JoaoWMHentz/Kinematech_Torq/Torq150A/Torq150A.step

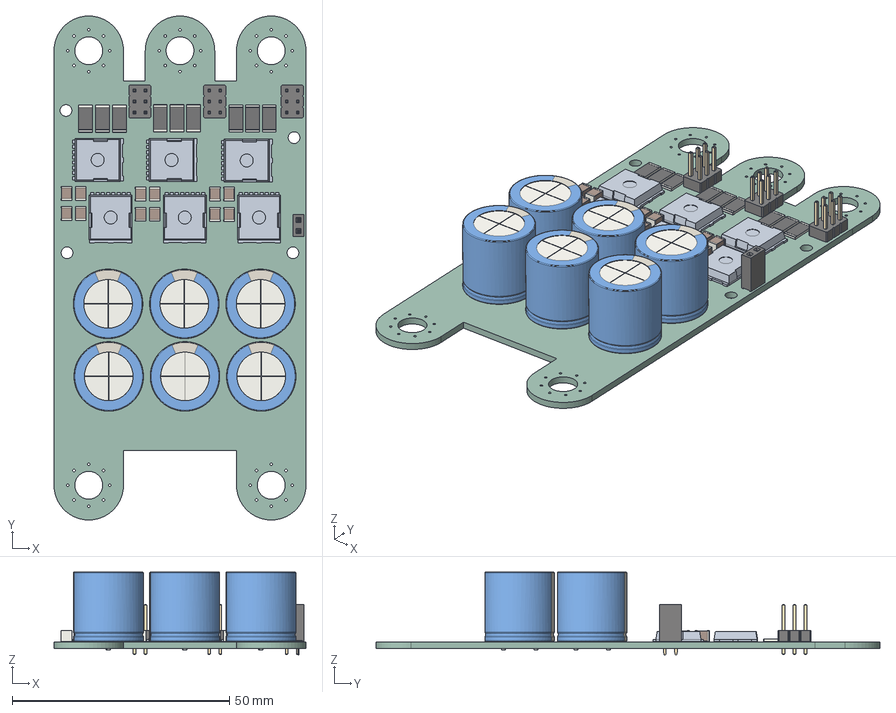
[picture p1: CAD file, 2025-09-10]
Torq150A/Torq150A.step
58.0 x 116.0 x 19.1 mm
C_1210_3225Metric x 12
PinSocket_1x02_P2.54mm_Vertical
PinHeader_2x03_P2.54mm_Vertical x 3
R_2512_6332Metric x 9
CP_Radial_D16.0mm_P7.50mm x 6
Torq150A 1.11.1 x 6
Torq150A_PCB
