JoaoWMHentz/Kinematech_Torq/TorqController/TorqController/Torq150.FCStd

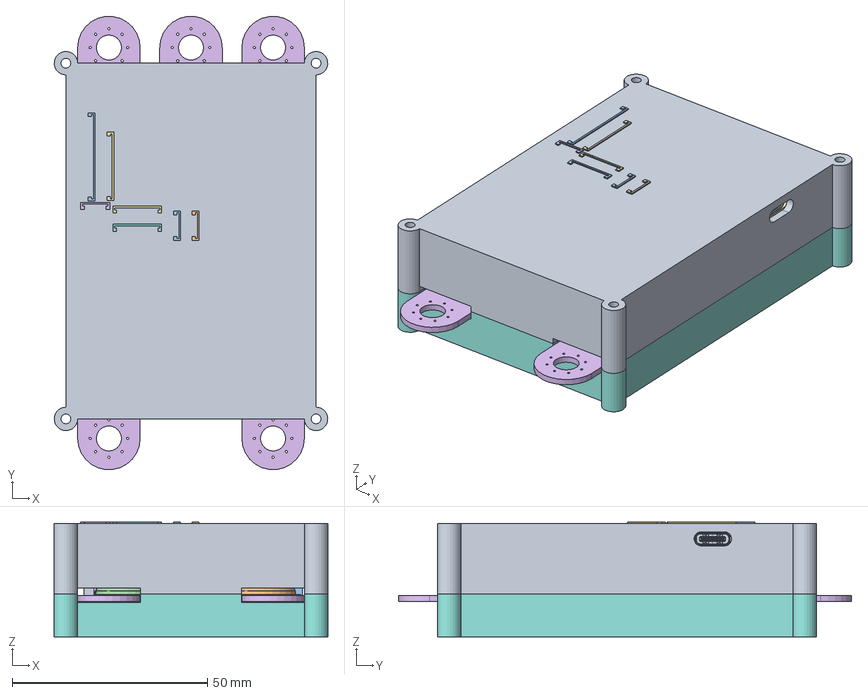
[picture p2: CAD file, 2025-09-10]
TorqController/TorqController/Torq150.FCStd
70.0 x 115.9 x 29.3 mm
C_1210_3225Metric
C_1210_3225Metric001
PinSocket_1x02_P2.54mm_Vertical
PinHeader_2x03_P2.54mm_Vertical
R_2512_6332Metric
C_1210_3225Metric002
CP_Radial_D16.0mm_P7.50mm
CP_Radial_D16.0mm_P7.50mm001
C_1210_3225Metric003
CP_Radial_D16.0mm_P7.50mm002
Torq150A 1.11.1
R_2512_6332Metric001
C_1210_3225Metric004
R_2512_6332Metric002
PinHeader_2x03_P2.54mm_Vertical001
R_2512_6332Metric003
Torq150A 1.11.002
R_2512_6332Metric004
R_2512_6332Metric005
Torq150A 1.11.003
CP_Radial_D16.0mm_P7.50mm003
R_2512_6332Metric006
C_1210_3225Metric005
R_2512_6332Metric007
Torq150A 1.11.004
C_1210_3225Metric006
CP_Radial_D16.0mm_P7.50mm004
CP_Radial_D16.0mm_P7.50mm005
C_1210_3225Metric007
C_1210_3225Metric008
C_1210_3225Metric009
C_1210_3225Metric010
Torq150A 1.11.005
Torq150A 1.11.006
C_1210_3225Metric011
PinHeader_2x03_P2.54mm_Vertical002
R_2512_6332Metric008
Torq150A_PCB
R_0402_1005Metric
C_0402_1005Metric
CP_Elec_3x5.4
R_0402_1005Metric001
R_0402_1005Metric002
WSON-8-1EP_3x3mm_P0.5mm_EP1.6x2.0mm
R_0402_1005Metric003
TSSOP-8_4.4x3mm_P0.65mm
R_0402_1005Metric004
CP_EIA-3216-10_Kemet-I
R_0402_1005Metric005
Texas_HTSSOP-14-1EP_4.4x5mm_P0.65mm_EP3.4x5mm_Mask3.155x3.255mm
R_0402_1005Metric006
C_0402_1005Metric001
C_0402_1005Metric002
CP_EIA-3216-10_Kemet-I001
C_0402_1005Metric003
R_0402_1005Metric007
R_0402_1005Metric008
R_0402_1005Metric009
R_0402_1005Metric010
R_0402_1005Metric011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
