JoaoWMHentz/Kinematech_Torq/Torq150A/Torq150A.kicad_pcb

## KiCad design Torq150A/Torq150A.kicad_pcb (2025-09-10)

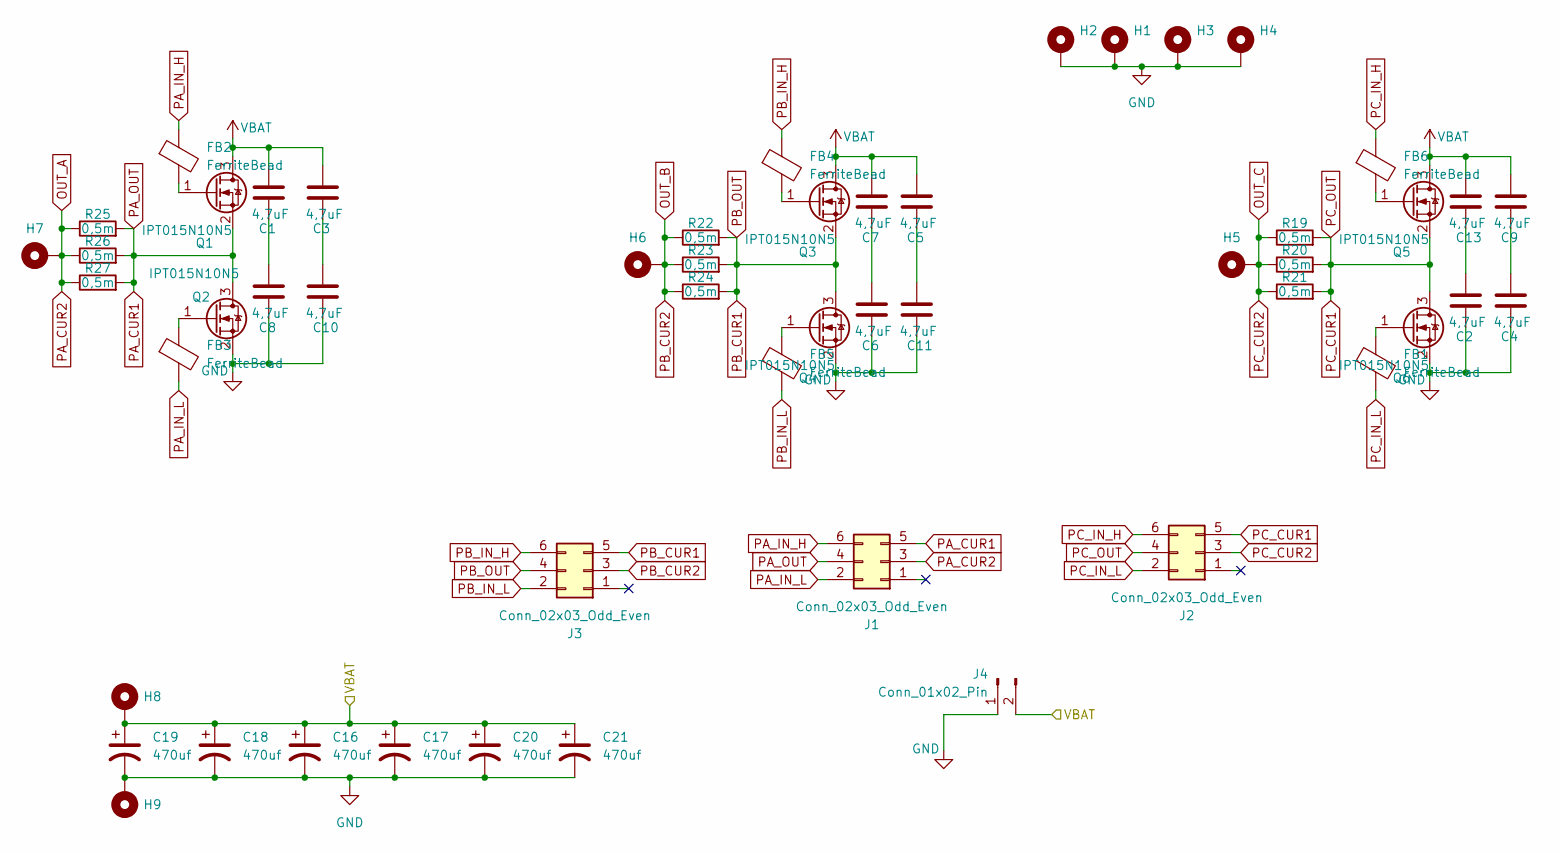
[picture p3: schematic Torq150A.kicad_sch]

Parts:
C1, C2, C3, C4, C5, C6, C7, C8, C9, C10, C11, C13: 4,7uF; C_1210_3225Metric
C16, C17, C18, C19, C20, C21: 470uf; CP_Radial_D16.0mm_P7.50mm
FB1, FB2, FB3, FB4, FB5, FB6: FerriteBead; L_Coilcraft_0805HQ_2012Metric
H1, H2, H3, H4: MountingHole_Pad; MountingHole_2.7mm_M2.5_ISO7380_Pad
H5, H6, H7, H8, H9: MountingHole_Pad; MountingHole_6.4mm_M6_Pad_Via
J1, J2, J3: Conn_02x03_Odd_Even; PinHeader_2x03_P2.54mm_Vertical
J4: Conn_01x02_Pin; PinSocket_1x02_P2.54mm_Vertical
Q1, Q2, Q3, Q4, Q5, Q6: IPT015N10N5; Infineon_PG-HSOF-8-1
R19, R20, R21, R22, R23, R24, R25, R26, R27: 0,5m; R_2512_6332Metric

Connections:
GND: C2.2, C4.2, C6.2, C8.2, C10.2, C11.2, C16.2, C17.2, C18.2, C19.2, C20.2, C21.2, H1.1, H2.1, H3.1, H4.1, H9.1, J4.1, Q2.2 (S), Q4.2 (S), Q6.2 (S)
unnamed: C1.2, C8.1
unnamed: C4.1, C9.2
unnamed: C6.1, C7.2
unnamed: C3.2, C10.1
unnamed: C5.2, C11.1
unnamed: C2.1, C13.2
unnamed: FB2.2, Q1.1 (G)
unnamed: FB3.1, Q2.1 (G)
unnamed: FB4.2, Q3.1 (G)
unnamed: FB5.1, Q4.1 (G)
unnamed: FB6.2, Q5.1 (G)
unnamed: FB1.1, Q6.1 (G)
OUT_A: H7.1, J1.3, R25.1, R26.1, R27.1
OUT_B: H6.1, J3.3, R22.1, R23.1, R24.1
OUT_C: H5.1, J2.3, R19.1, R20.1, R21.1
PA_CUR1: J1.4, J1.5, Q1.2 (S), Q2.3 (D), R25.2, R26.2, R27.2
PA_IN_H: FB2.1, J1.6
PA_IN_L: FB3.2, J1.2
PB_CUR1: J3.4, J3.5, Q3.2 (S), Q4.3 (D), R22.2, R23.2, R24.2
PB_IN_H: FB4.1, J3.6
PB_IN_L: FB5.2, J3.2
PC_CUR1: J2.4, J2.5, Q5.2 (S), Q6.3 (D), R19.2, R20.2, R21.2
PC_IN_H: FB6.1, J2.6
PC_IN_L: FB1.2, J2.2
VBAT: C1.1, C3.1, C5.1, C7.1, C9.1, C13.1, C16.1, C17.1, C18.1, C19.1, C20.1, C21.1, H8.1, J4.2, Q1.3 (D), Q3.3 (D), Q5.3 (D)

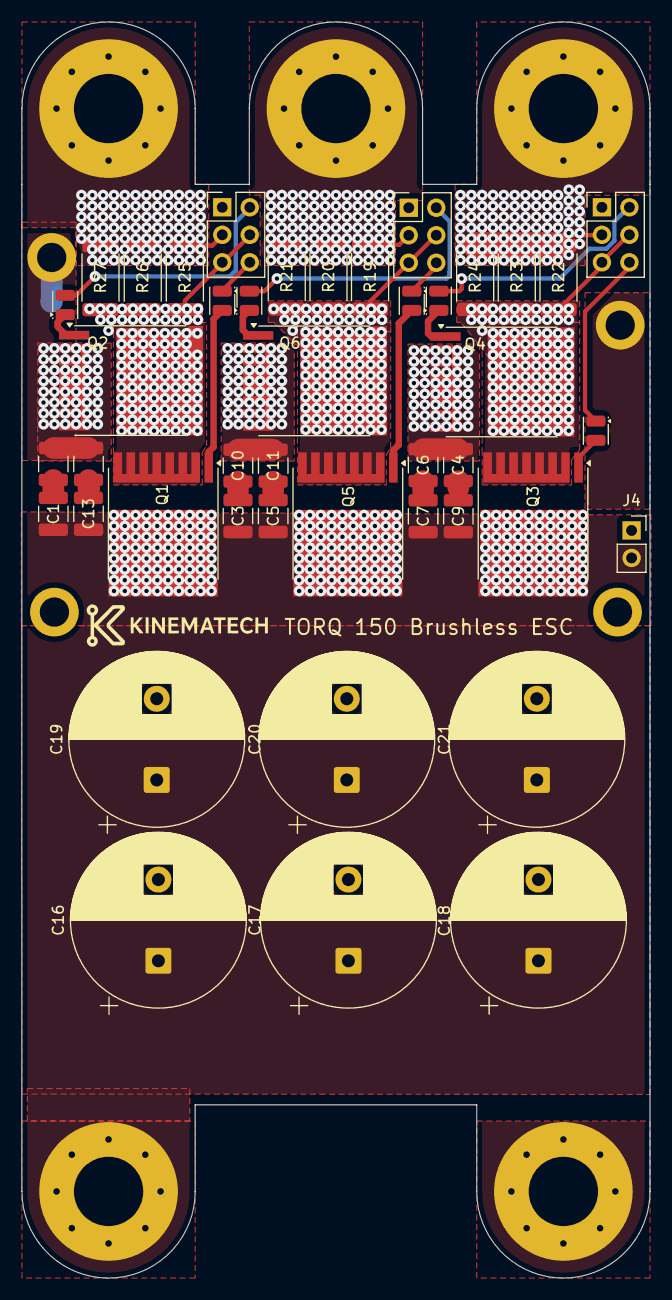
[picture p4: board Torq150A.kicad_pcb from above]

Board: 2 copper layers, 58.0 x 116.0 mm, 52 parts (0 on the bottom side), 26 nets.
