JoaoWMHentz/Kinematech_Torq/TorqController/TorqController/TorqController.kicad_pcb

## KiCad design TorqController/TorqController/TorqController.kicad_pcb (2025-09-10)

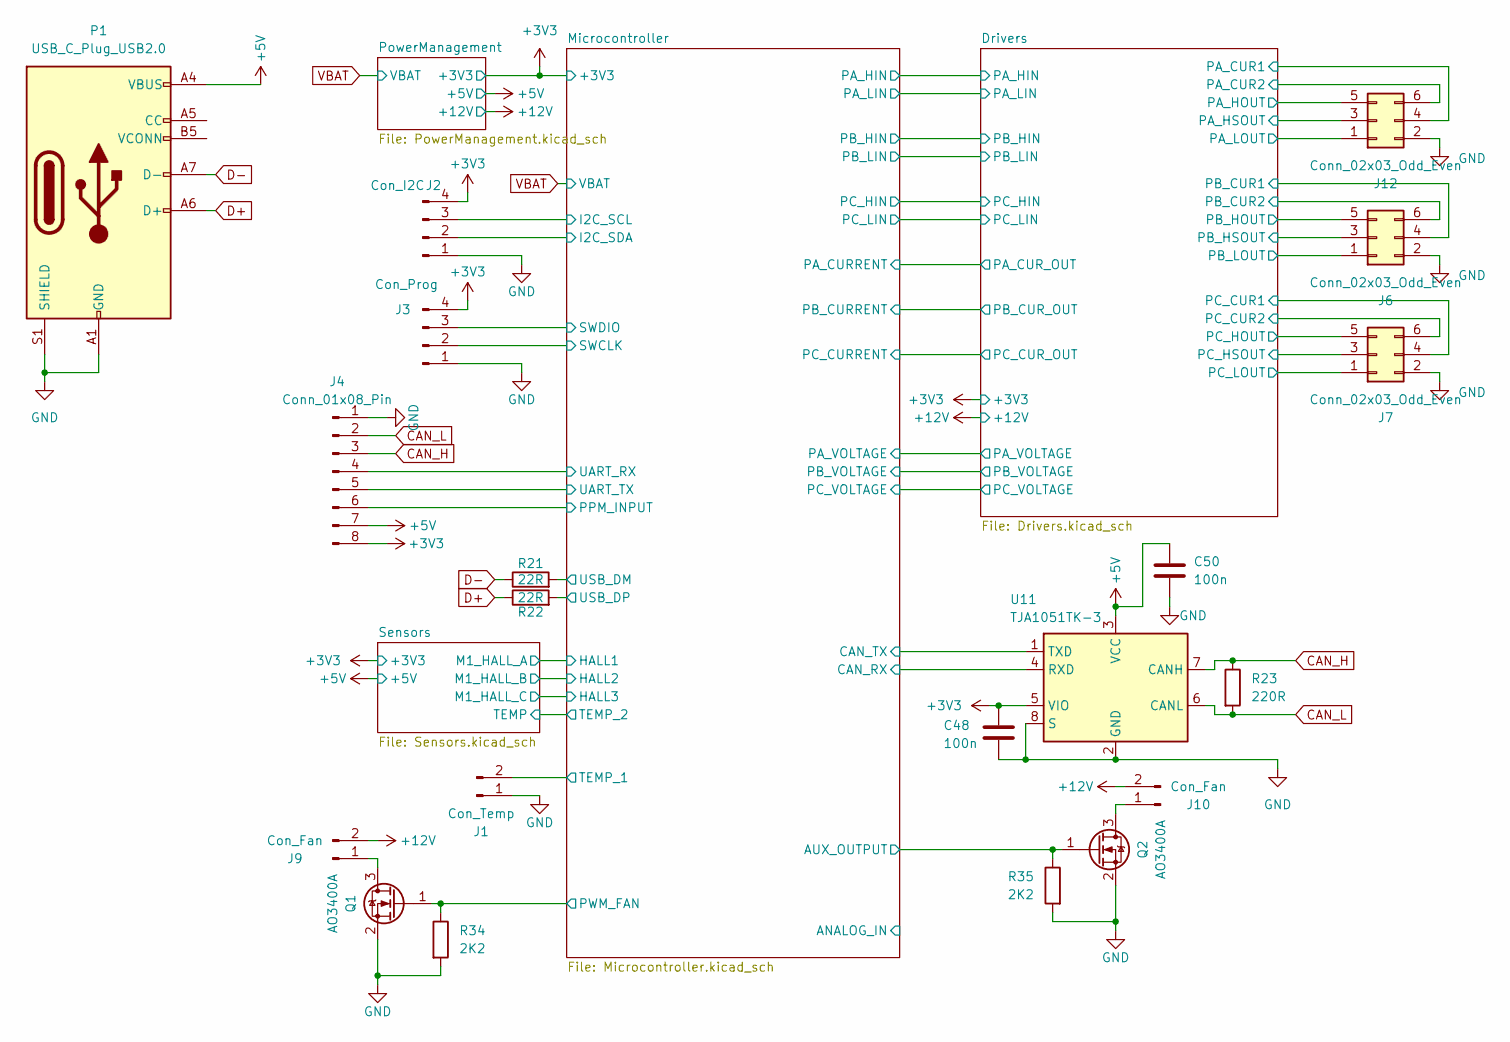
[picture p5: schematic TorqController.kicad_sch]

Parts:
C48, C50: 100n; C_0402_1005Metric
J1: Con_Temp; JST_EH_B2B-EH-A_1x02_P2.50mm_Vertical
J2: Con_I2C; JST_EH_B4B-EH-A_1x04_P2.50mm_Vertical
J3: Con_Prog; JST_EH_B4B-EH-A_1x04_P2.50mm_Vertical
J4: Conn_01x08_Pin; JST_EH_B8B-EH-A_1x08_P2.50mm_Vertical
J6, J7, J12: Conn_02x03_Odd_Even; PinHeader_2x03_P2.54mm_Vertical
J9, J10: Con_Fan; JST_EH_B2B-EH-A_1x02_P2.50mm_Vertical
P1: USB_C_Plug_USB2.0; USB_C_Receptacle_G-Switch_GT-USB-7010ASV
Q1, Q2: AO3400A; SOT-23
R21, R22: 22R; R_0402_1005Metric
R23: 220R; R_0402_1005Metric
R34, R35: 2K2; R_0402_1005Metric
U11: TJA1051TK-3; HVSON-8-1EP_3x3mm_P0.65mm_EP1.6x2.4mm

Connections:
+3V3: C48.1, J2.4, J3.4, J4.8, U11.5 (VIO); also elsewhere on the board
+5V: C50.1, J4.7, P1.A4 (VBUS), P1.A9 (VBUS), P1.B4 (VBUS), P1.B9 (VBUS), U11.3 (VCC); also elsewhere on the board
+12V: J9.2, J10.2; also elsewhere on the board
/Drivers/PA_CUR1: J12.4; also elsewhere on the board
/Drivers/PA_CUR2: J12.6; also elsewhere on the board
/Drivers/PA_HOUT: J12.5; also elsewhere on the board
/Drivers/PA_HSOUT: J12.3; also elsewhere on the board
/Drivers/PA_LOUT: J12.1; also elsewhere on the board
/Drivers/PB_CUR1: J6.4; also elsewhere on the board
/Drivers/PB_CUR2: J6.6; also elsewhere on the board
/Drivers/PB_HOUT: J6.5; also elsewhere on the board
/Drivers/PB_HSOUT: J6.3; also elsewhere on the board
/Drivers/PB_LOUT: J6.1; also elsewhere on the board
/Drivers/PC_CUR1: J7.4; also elsewhere on the board
/Drivers/PC_CUR2: J7.6; also elsewhere on the board
/Drivers/PC_HOUT: J7.5; also elsewhere on the board
/Drivers/PC_HSOUT: J7.3; also elsewhere on the board
/Drivers/PC_LOUT: J7.1; also elsewhere on the board
/Microcontroller/AUX_OUTPUT: Q2.1 (G), R35.1; also elsewhere on the board
/Microcontroller/CAN_RX: U11.4 (RXD); also elsewhere on the board
/Microcontroller/CAN_TX: U11.1 (TXD); also elsewhere on the board
/Microcontroller/I2C_SCL: J2.3; also elsewhere on the board
/Microcontroller/I2C_SDA: J2.2; also elsewhere on the board
/Microcontroller/PPM_INPUT: J4.6; also elsewhere on the board
/Microcontroller/PWM_FAN: Q1.1 (G), R34.1; also elsewhere on the board
/Microcontroller/SWCLK: J3.2; also elsewhere on the board
/Microcontroller/SWDIO: J3.3; also elsewhere on the board
/Microcontroller/UART_RX: J4.4; also elsewhere on the board
/Microcontroller/UART_TX: J4.5; also elsewhere on the board
/Microcontroller/USB_DM: R21.2; also elsewhere on the board
/Microcontroller/USB_DP: R22.2; also elsewhere on the board
CAN_H: J4.3, R23.1, U11.7 (CANH)
CAN_L: J4.2, R23.2, U11.6 (CANL)
D+: P1.A6 (D+), R22.1
D-: P1.A7 (D-), R21.1
GND: C48.2, C50.2, J1.1, J2.1, J3.1, J4.1, J6.2, J7.2, J12.2, P1.A1 (GND), P1.A12 (GND), P1.B1 (GND), P1.B12 (GND), P1.S1 (SHIELD), Q1.2 (S), Q2.2 (S), R34.2, R35.2, U11.2 (GND), U11.8 (S), U11.9 (GND); also elsewhere on the board
unnamed: J9.1, Q1.3 (D)
unnamed: J10.1, Q2.3 (D)
Temp_1: J1.2; also elsewhere on the board

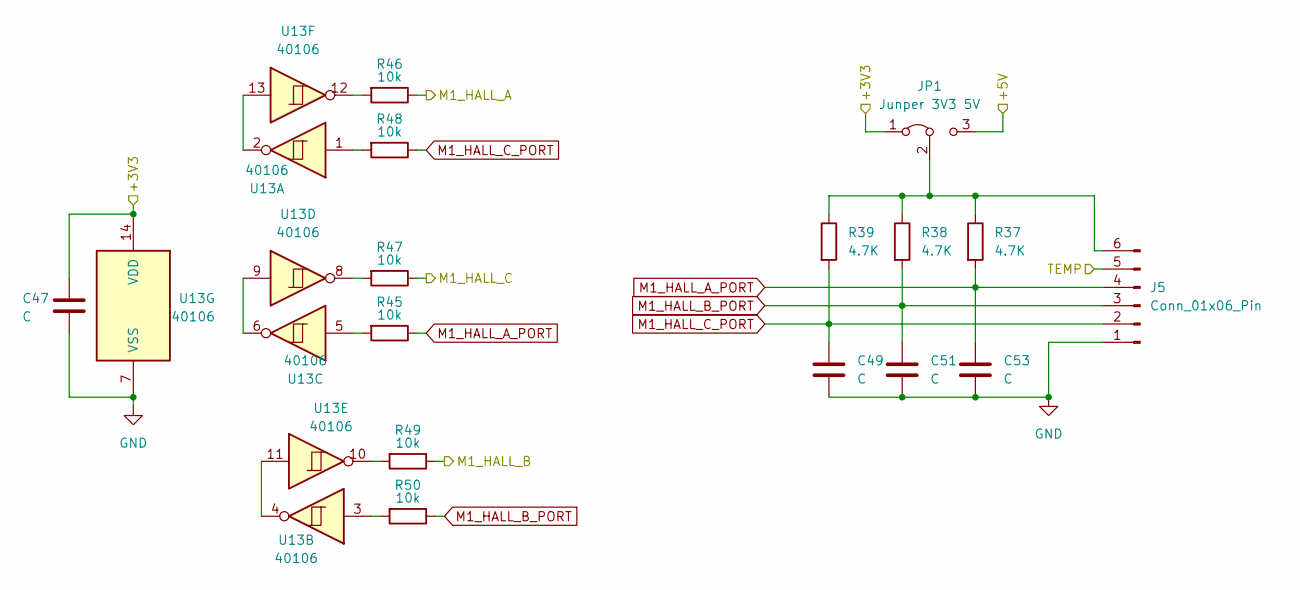
[picture p6: schematic Sensors.kicad_sch]

Parts:
C47, C49, C51, C53: C; C_0402_1005Metric
J5: Conn_01x06_Pin; JST_EH_B6B-EH-A_1x06_P2.50mm_Vertical
JP1: Junper 3V3 5V; SolderJumper-3_P1.3mm_Open_RoundedPad1.0x1.5mm_NumberLabels
R37, R38, R39: 4.7K; R_0402_1005Metric
R45, R46, R47, R48, R49, R50: 10k; R_0402_1005Metric
U13: 40106; DIP-14_W7.62mm_SMDSocket_SmallPads

Connections:
+3V3: C47.1, JP1.1 (A), U13.14 (VDD); also elsewhere on the board
/Microcontroller/HALL1: R46.1; also elsewhere on the board
/Microcontroller/HALL2: R49.1; also elsewhere on the board
/Microcontroller/HALL3: R47.1; also elsewhere on the board
GND: C47.2, C49.2, C51.2, C53.2, J5.1, U13.7 (VSS); also elsewhere on the board
M1_HALL_A_PORT: C53.1, J5.4, R37.2, R45.1
M1_HALL_B_PORT: C51.1, J5.3, R38.2, R50.1
M1_HALL_C_PORT: C49.1, J5.2, R39.2, R48.1
unnamed 60: J5.6, JP1.2 (C), R37.1, R38.1, R39.1; also elsewhere on the board
unnamed: R45.2, U13.5
unnamed: R46.2, U13.12
unnamed: R47.2, U13.8
unnamed: R48.2, U13.1
unnamed: R49.2, U13.10
unnamed: R50.2, U13.3
unnamed: U13.6, U13.9
unnamed: U13.4, U13.11
unnamed: U13.2, U13.13
Temp_2: J5.5; also elsewhere on the board

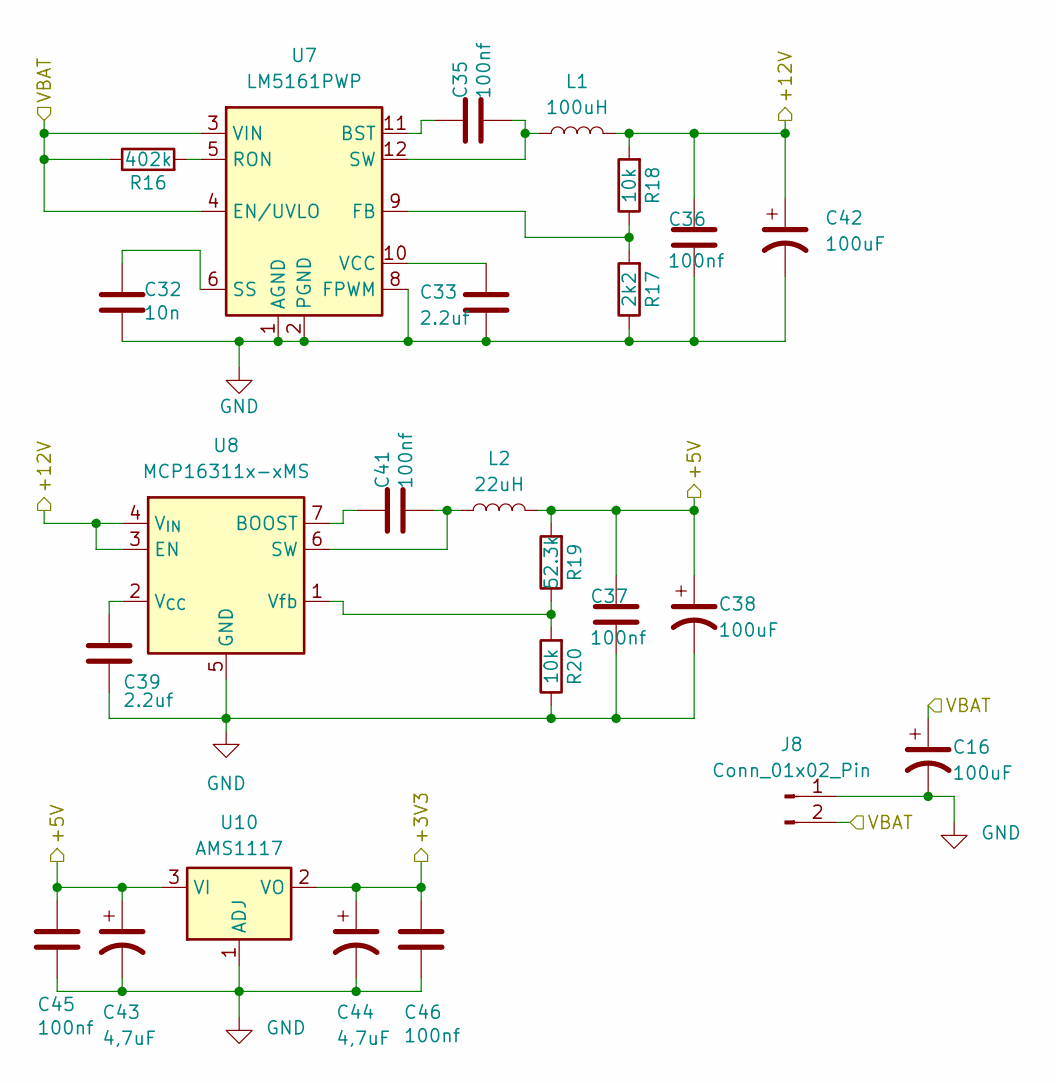
[picture p7: schematic PowerManagement.kicad_sch]

Parts:
C16, C38, C42: 100uF; CP_Elec_3x5.4
C32: 10n; C_0402_1005Metric
C33, C39: 2.2uf; C_0603_1608Metric
C35, C36, C37, C41, C45, C46: 100nf; C_0402_1005Metric
C43, C44: 4,7uF; CP_EIA-3216-10_Kemet-I
J8: Conn_01x02_Pin; PinHeader_1x02_P2.54mm_Vertical
L1: 100uH; L_KOHERelec_MDA5030
L2: 22uH; L_Chilisin_BMRB00050518-B
R16: 402k; R_0402_1005Metric
R17: 2k2; R_0402_1005Metric
R18, R20: 10k; R_0402_1005Metric
R19: 52.3k; R_0402_1005Metric
U7: LM5161PWP; Texas_HTSSOP-14-1EP_4.4x5mm_P0.65mm_EP3.4x5mm_Mask3.155x3.2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
U8: MCP16311x-xMS; MSOP-8_3x3mm_P0.65mm
U10: AMS1117; SOT-223-3_TabPin2

Connections:
+3V3: C44.1, C46.1, U10.2 (VO); also elsewhere on the board
+5V: C37.2, C38.1, C43.1, C45.1, L2.2, R19.2, U10.3 (VI); also elsewhere on the board
+12V: C36.2, C42.1, L1.2, R18.2, U8.3 (EN), U8.4 (V_{IN}); also elsewhere on the board
GND: C16.2, C32.2, C33.2, C36.1, C37.1, C38.2, C39.2, C42.2, C43.2, C44.2, C45.2, C46.2, J8.1, R17.1, R20.1, U7.1 (AGND), U7.2 (PGND), U7.8 (FPWM), U7.15 (AGND), U8.5 (GND), U8.8 (GND), U10.1 (ADJ); also elsewhere on the board
unnamed: C35.2, L1.1, U7.12 (SW), U7.13 (SW)
unnamed: C35.1, U7.11 (BST)
unnamed: R17.2, R18.1, U7.9 (FB)
unnamed: R16.2, U7.5 (RON)
unnamed: C32.1, U7.6 (SS)
unnamed: C33.1, U7.10 (VCC)
unnamed: C41.1, U8.7 (BOOST)
unnamed: C41.2, L2.1, U8.6 (SW)
unnamed: C39.1, U8.2 (V_{CC})
unnamed: R19.1, R20.2, U8.1 (Vfb)
VBAT: C16.1, J8.2, R16.1, U7.3 (VIN), U7.4 (EN/UVLO); also elsewhere on the board

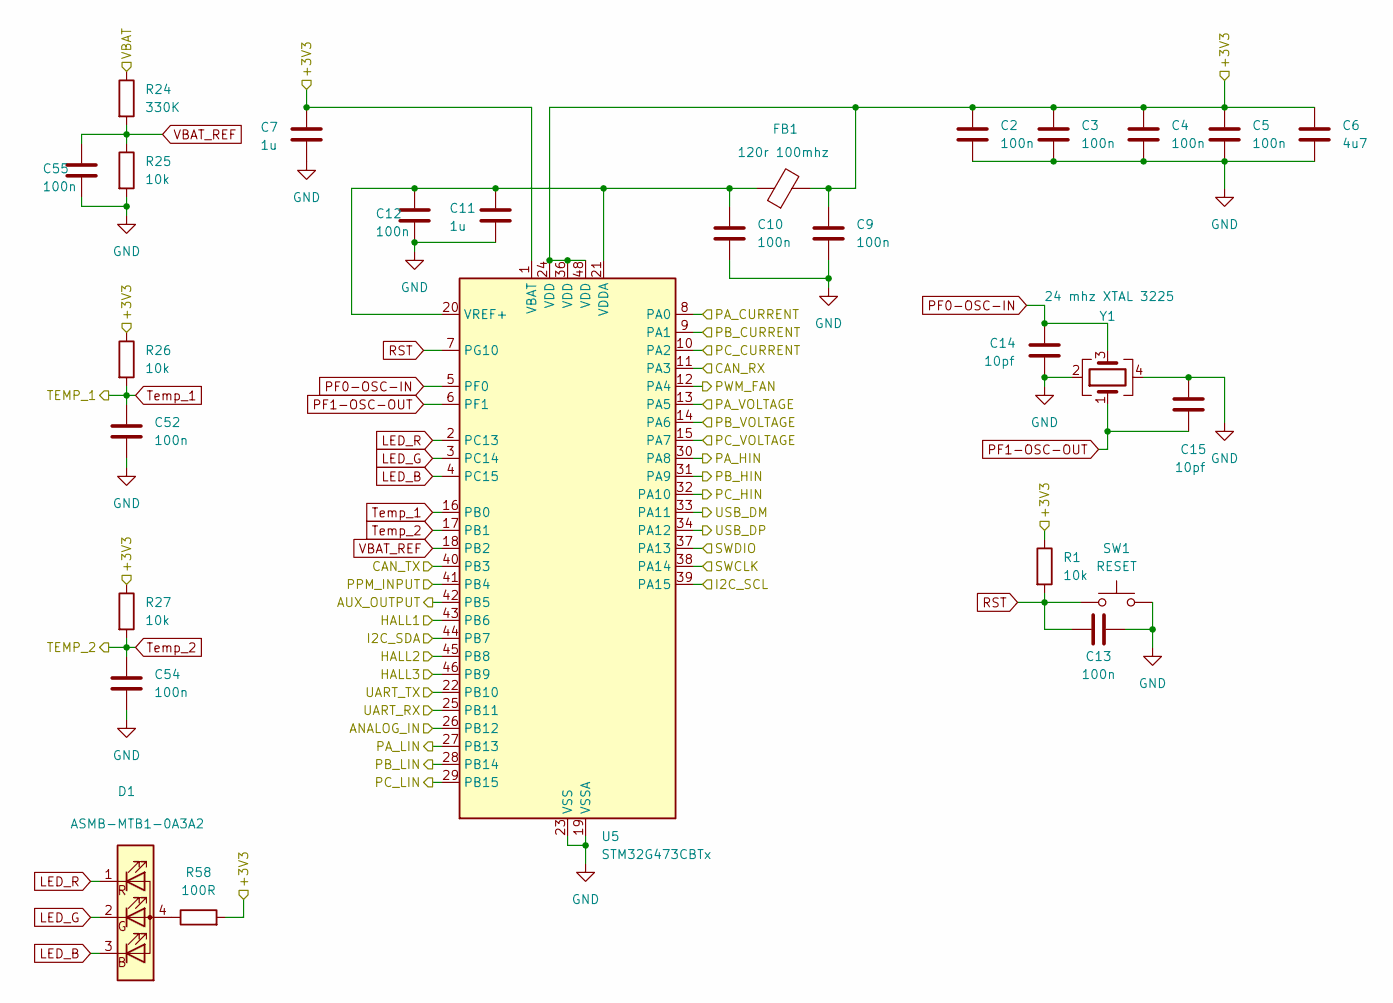
[picture p8: schematic Microcontroller.kicad_sch]

Parts:
C2, C3, C4, C5, C9, C10, C12, C13, C52, C54, C55: 100n; C_0402_1005Metric
C6: 4u7; C_0402_1005Metric
C7, C11: 1u; C_0402_1005Metric
C14, C15: 10pf; C_0402_1005Metric
D1: ASMB-MTB1-0A3A2; LED_Avago_PLCC4_3.2x2.8mm_CW
FB1: 120r 100mhz; L_0402_1005Metric
R1, R25, R26, R27: 10k; R_0402_1005Metric
R24: 330K; R_0402_1005Metric
R58: 100R; R_0603_1608Metric_Pad0.98x0.95mm_HandSolder
SW1: RESET; SW_SPST_B3U-1000P
U5: STM32G473CBTx; LQFP-48_7x7mm_P0.5mm
Y1: 24 mhz XTAL 3225; Crystal_SMD_2016-4Pin_2.0x1.6mm

Connections:
+3V3: C2.1, C3.1, C4.1, C5.1, C6.1, C7.1, C9.1, FB1.2, R1.1, R26.1, R27.1, R58.2, U5.1 (VBAT), U5.24 (VDD), U5.36 (VDD), U5.48 (VDD); also elsewhere on the board
/Drivers/PA_CUR_OUT: U5.8 (PA0); also elsewhere on the board
/Drivers/PA_HIN: U5.30 (PA8); also elsewhere on the board
/Drivers/PA_LIN: U5.27 (PB13); also elsewhere on the board
/Drivers/PA_VOLTAGE: U5.13 (PA5); also elsewhere on the board
/Drivers/PB_CUR_OUT: U5.9 (PA1); also elsewhere on the board
/Drivers/PB_HIN: U5.31 (PA9); also elsewhere on the board
/Drivers/PB_LIN: U5.28 (PB14); also elsewhere on the board
/Drivers/PB_VOLTAGE: U5.14 (PA6); also elsewhere on the board
/Drivers/PC_CUR_OUT: U5.10 (PA2); also elsewhere on the board
/Drivers/PC_HIN: U5.32 (PA10); also elsewhere on the board
/Drivers/PC_LIN: U5.29 (PB15); also elsewhere on the board
/Drivers/PC_VOLTAGE: U5.15 (PA7); also elsewhere on the board
/Microcontroller/ANALOG_IN: U5.26 (PB12)
/Microcontroller/AUX_OUTPUT: U5.42 (PB5); also elsewhere on the board
/Microcontroller/CAN_RX: U5.11 (PA3); also elsewhere on the board
/Microcontroller/CAN_TX: U5.40 (PB3); also elsewhere on the board
/Microcontroller/HALL1: U5.43 (PB6); also elsewhere on the board
/Microcontroller/HALL2: U5.45 (PB8); also elsewhere on the board
/Microcontroller/HALL3: U5.46 (PB9); also elsewhere on the board
/Microcontroller/I2C_SCL: U5.39 (PA15); also elsewhere on the board
/Microcontroller/I2C_SDA: U5.44 (PB7); also elsewhere on the board
/Microcontroller/PPM_INPUT: U5.41 (PB4); also elsewhere on the board
/Microcontroller/PWM_FAN: U5.12 (PA4); also elsewhere on the board
/Microcontroller/SWCLK: U5.38 (PA14); also elsewhere on the board
/Microcontroller/SWDIO: U5.37 (PA13); also elsewhere on the board
/Microcontroller/UART_RX: U5.25 (PB11); also elsewhere on the board
/Microcontroller/UART_TX: U5.22 (PB10); also elsewhere on the board
/Microcontroller/USB_DM: U5.33 (PA11); also elsewhere on the board
/Microcontroller/USB_DP: U5.34 (PA12); also elsewhere on the board
GND: C2.2, C3.2, C4.2, C5.2, C6.2, C7.2, C9.2, C10.2, C11.2, C12.2, C13.2, C14.2, C15.1, C52.2, C54.2, C55.2, R25.2, SW1.2, U5.19 (VSSA), U5.23 (VSS), U5.35 (VSS), U5.47 (VSS), Y1.2, Y1.4; also elsewhere on the board
LED_B: D1.3 (BK), U5.4 (PC15)
LED_G: D1.2 (GK), U5.3 (PC14)
LED_R: D1.1 (RK), U5.2 (PC13)
unnamed: D1.4 (A), R58.1
unnamed: C10.1, C11.1, C12.1, FB1.1, U5.20 (VREF+), U5.21 (VDDA)
PF0-OSC-IN: C14.1, U5.5 (PF0), Y1.3
PF1-OSC-OUT: C15.2, U5.6 (PF1), Y1.1
RST: C13.1, R1.2, SW1.1, U5.7 (PG10)
Temp_1: C52.1, R26.2, U5.16 (PB0); also elsewhere on the board
Temp_2: C54.1, R27.2, U5.17 (PB1); also elsewhere on the board
VBAT: R24.1; also elsewhere on the board
VBAT_REF: C55.1, R24.2, R25.1, U5.18 (PB2)

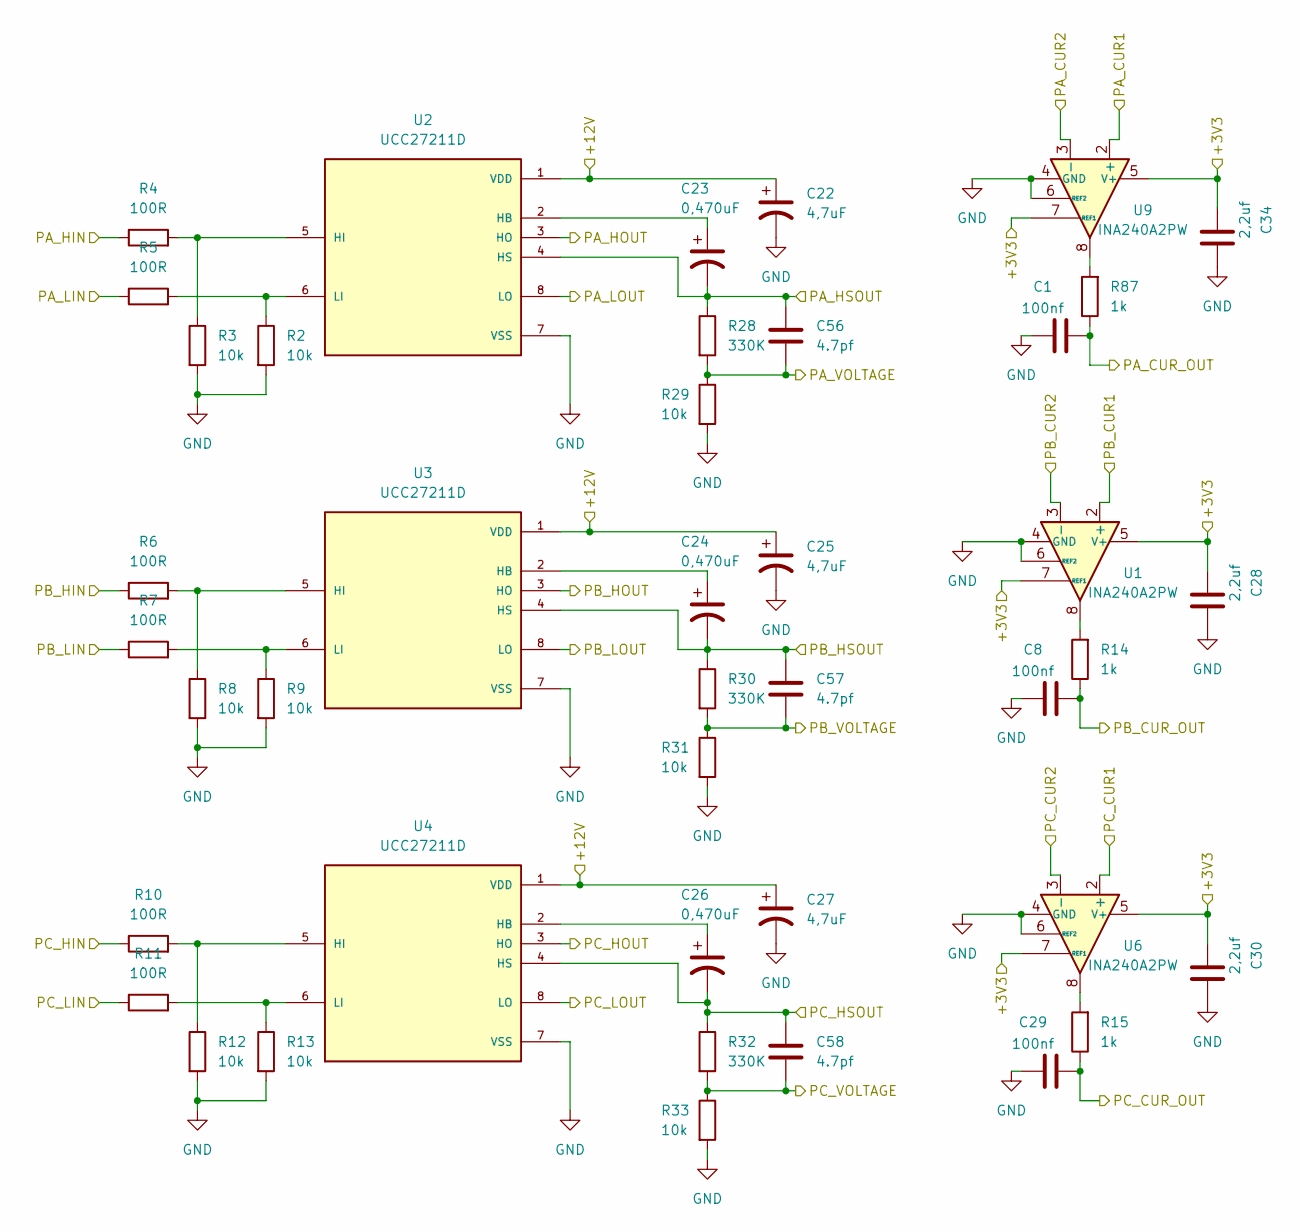
[picture p9: schematic Drivers.kicad_sch]

Parts:
C1, C8, C29: 100nf; C_0402_1005Metric
C22, C25, C27: 4,7uF; CP_EIA-3216-10_Kemet-I
C23, C24, C26: 0,470uF; CP_EIA-3216-10_Kemet-I
C28, C30, C34: 2,2uf; C_0402_1005Metric
C56, C57, C58: 4.7pf; C_0402_1005Metric
R2, R3, R8, R9, R12, R13, R29, R31, R33: 10k; R_0402_1005Metric
R4, R5, R6, R7, R10, R11: 100R; R_0402_1005Metric
R14, R15, R87: 1k; R_0402_1005Metric
R28, R30, R32: 330K; R_0402_1005Metric
U1, U6, U9: INA240A2PW; TSSOP-8_4.4x3mm_P0.65mm
U2, U3, U4: UCC27211D; HSOP-8-1EP_3.9x4.9mm_P1.27mm_EP2.41x3.1mm_ThermalVias; PARTREV F

Connections:
+3V3: C28.1, C30.1, C34.1, U1.5 (V+), U1.7 (REF1), U6.5 (V+), U6.7 (REF1), U9.5 (V+), U9.7 (REF1); also elsewhere on the board
+12V: C22.1, C25.1, C27.1, U2.1 (VDD), U3.1 (VDD), U4.1 (VDD); also elsewhere on the board
/Drivers/PA_CUR1: U9.2 (+); also elsewhere on the board
/Drivers/PA_CUR2: U9.3 (-); also elsewhere on the board
/Drivers/PA_CUR_OUT: C1.2, R87.1; also elsewhere on the board
/Drivers/PA_HIN: R4.1; also elsewhere on the board
/Drivers/PA_HOUT: U2.3 (HO); also elsewhere on the board
/Drivers/PA_HSOUT: C23.2, C56.1, R28.1, U2.4 (HS); also elsewhere on the board
/Drivers/PA_LIN: R5.1; also elsewhere on the board
/Drivers/PA_LOUT: U2.8 (LO); also elsewhere on the board
/Drivers/PA_VOLTAGE: C56.2, R28.2, R29.1; also elsewhere on the board
/Drivers/PB_CUR1: U1.2 (+); also elsewhere on the board
/Drivers/PB_CUR2: U1.3 (-); also elsewhere on the board
/Drivers/PB_CUR_OUT: C8.2, R14.1; also elsewhere on the board
/Drivers/PB_HIN: R6.1; also elsewhere on the board
/Drivers/PB_HOUT: U3.3 (HO); also elsewhere on the board
/Drivers/PB_HSOUT: C24.2, C57.1, R30.1, U3.4 (HS); also elsewhere on the board
/Drivers/PB_LIN: R7.1; also elsewhere on the board
/Drivers/PB_LOUT: U3.8 (LO); also elsewhere on the board
/Drivers/PB_VOLTAGE: C57.2, R30.2, R31.1; also elsewhere on the board
/Drivers/PC_CUR1: U6.2 (+); also elsewhere on the board
/Drivers/PC_CUR2: U6.3 (-); also elsewhere on the board
/Drivers/PC_CUR_OUT: C29.2, R15.1; also elsewhere on the board
/Drivers/PC_HIN: R10.1; also elsewhere on the board
/Drivers/PC_HOUT: U4.3 (HO); also elsewhere on the board
/Drivers/PC_HSOUT: C26.2, C58.1, R32.1, U4.4 (HS); also elsewhere on the board
/Drivers/PC_LIN: R11.1; also elsewhere on the board
/Drivers/PC_LOUT: U4.8 (LO); also elsewhere on the board
/Drivers/PC_VOLTAGE: C58.2, R32.2, R33.1; also elsewhere on the board
GND: C1.1, C8.1, C22.2, C25.2, C27.2, C28.2, C29.1, C30.2, C34.2, R2.2, R3.2, R8.2, R9.2, R12.2, R13.2, R29.2, R31.2, R33.2, U1.1 (GND), U1.4 (GND), U1.6 (REF2), U2.7 (VSS), U3.7 (VSS), U4.7 (VSS), U6.1 (GND), U6.4 (GND), U6.6 (REF2), U9.1 (GND), U9.4 (GND), U9.6 (REF2); also elsewhere on the board
unnamed: R14.2, U1.8
unnamed: R15.2, U6.8
unnamed: R87.2, U9.8
unnamed: C23.1, U2.2 (HB)
unnamed: R3.1, R4.2, U2.5 (HI)
unnamed: R2.1, R5.2, U2.6 (LI)
unnamed: C24.1, U3.2 (HB)
unnamed: R6.2, R8.1, U3.5 (HI)
unnamed: R7.2, R9.1, U3.6 (LI)
unnamed: C26.1, U4.2 (HB)
unnamed: R10.2, R12.1, U4.5 (HI)
unnamed: R11.2, R13.1, U4.6 (LI)

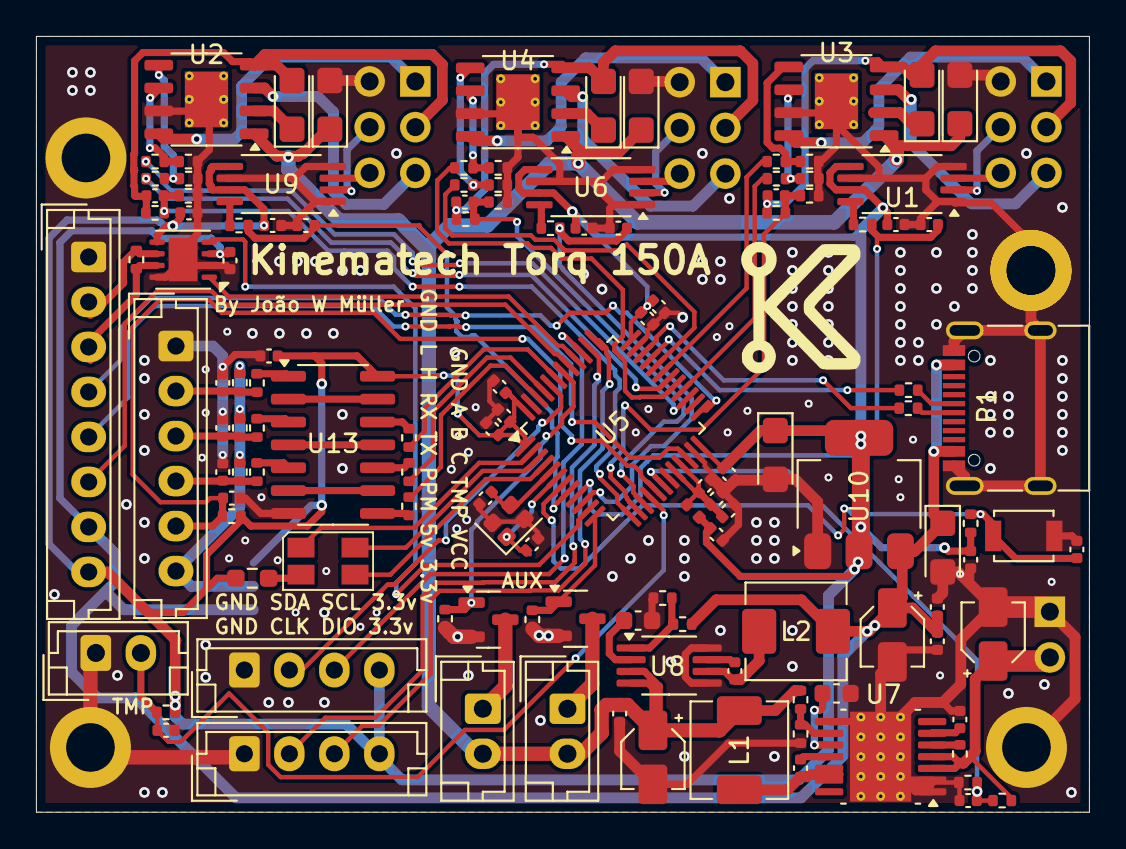
[picture p10: board TorqController.kicad_pcb from above]

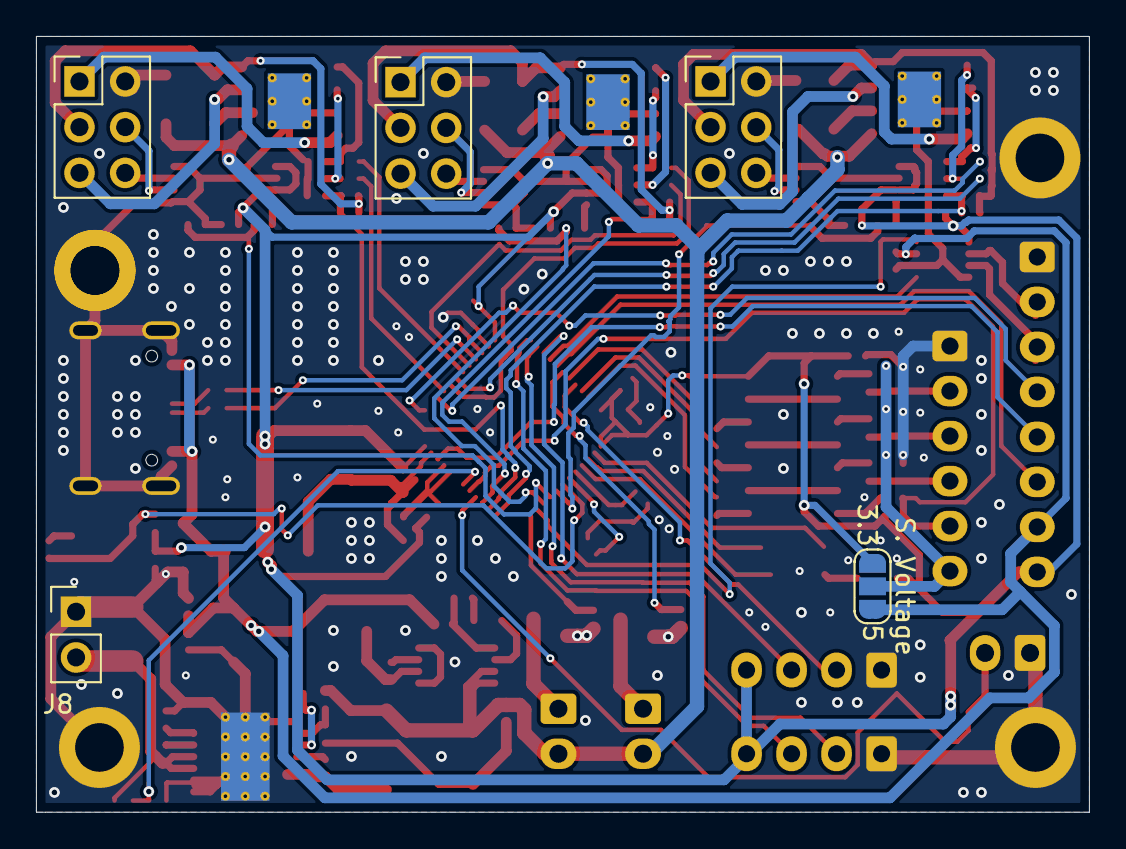
[picture p11: board TorqController.kicad_pcb from below]

Board: 2 copper layers, 58.5 x 43.1 mm, 132 parts (5 on the bottom side), 100 nets.

Other parts of the board:
H2, H4: MountingHole_Pad; MountingHole_2.7mm_M2.5_ISO7380_Pad
S. Voltage: Junper 3V3 5V; SolderJumper-3_P1.3mm_Open_RoundedPad1.0x1.5mm_NumberLabels

Their connections:
+3V3: S. Voltage.1 (A); also elsewhere on the board
+5V: S. Voltage.3 (B); also elsewhere on the board
GND: H2.1, H4.1; also elsewhere on the board
unnamed 60: S. Voltage.2 (C); also elsewhere on the board
