JoaoWMHentz/Kinematech_Torq/Torq300A/Torq300A.kicad_pcb

## KiCad design Torq300A/Torq300A.kicad_pcb (2025-09-10)

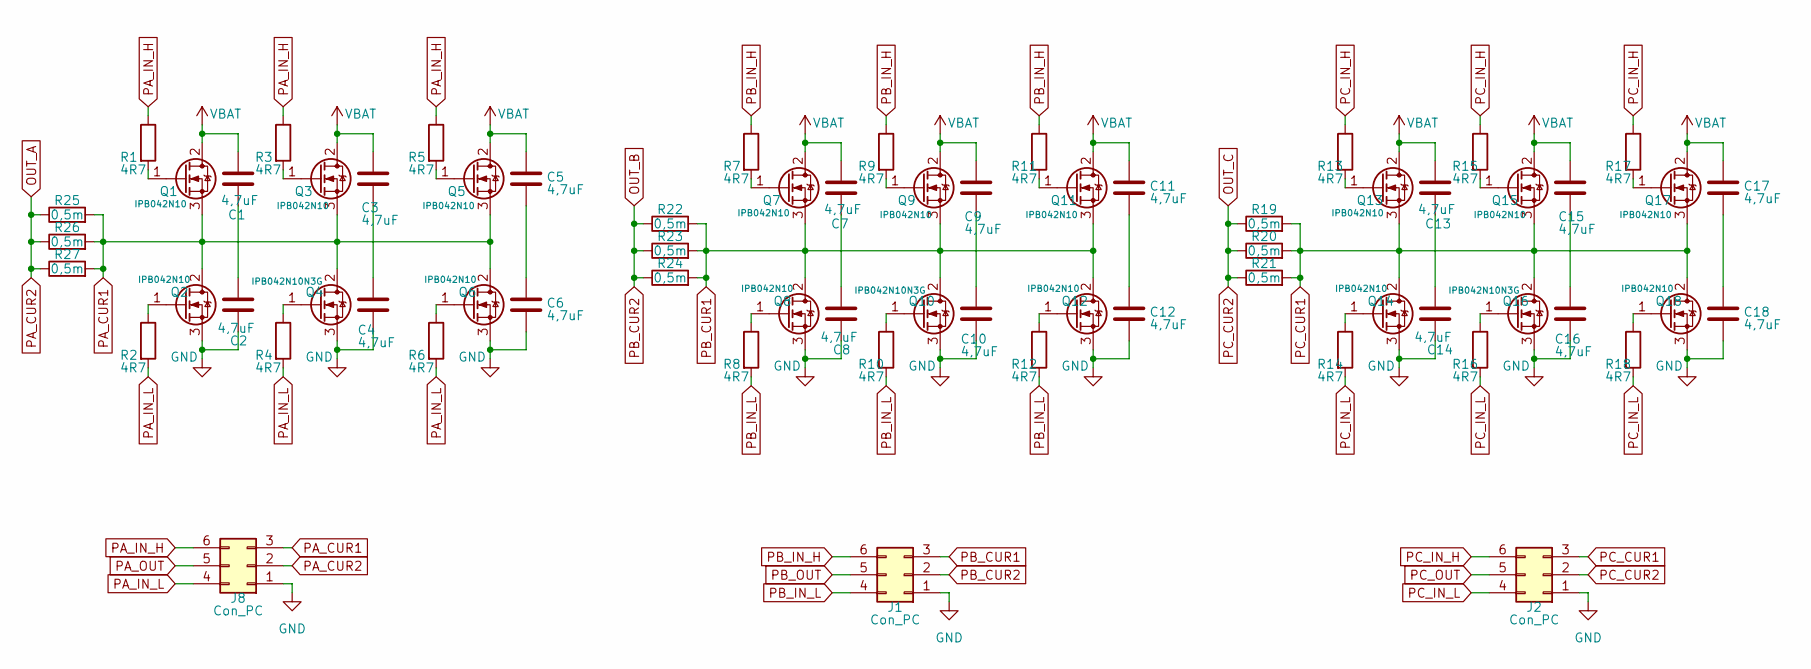
[picture p12: schematic Torq300A.kicad_sch]

Parts:
C1, C2, C3, C4, C5, C6, C7, C8, C9, C10, C11, C12, C13, C14, C15, C16, C17, C18: 4,7uF; C_1210_3225Metric
J1, J2, J8: Con_PC; PinHeader_2x03_P2.54mm_Vertical
Q1, Q2, Q3, Q5, Q6, Q7, Q8, Q9, Q11, Q12, Q13, Q14, Q15, Q17, Q18: IPB042N10; TO-263-2
Q4, Q10, Q16: IPB042N10N3G; TO-263-2
R1, R2, R3, R4, R5, R6, R7, R8, R9, R10, R11, R12, R13, R14, R15, R16, R17, R18: 4R7; R_0603_1608Metric
R19, R20, R21, R22, R23, R24, R25, R26, R27: 0,5m; R_2512_6332Metric

Connections:
GND: C2.2, C4.2, C6.2, C8.2, C10.2, C12.2, C14.2, C16.2, C18.2, J1.1, J2.1, J8.1, Q2.3 (S), Q4.3 (S), Q6.3 (S), Q8.3 (S), Q10.3 (S), Q12.3 (S), Q14.3 (S), Q16.3 (S), Q18.3 (S)
unnamed: C1.2, C2.1
unnamed: C3.2, C4.1
unnamed: C5.2, C6.1
unnamed: C7.2, C8.1
unnamed: C9.2, C10.1
unnamed: C11.2, C12.1
unnamed: C13.2, C14.1
unnamed: C15.2, C16.1
unnamed: C17.2, C18.1
unnamed: Q1.1 (G), R1.2
unnamed: Q2.1 (G), R2.1
unnamed: Q3.1 (G), R3.2
unnamed: Q4.1 (G), R4.1
unnamed: Q5.1 (G), R5.2
unnamed: Q6.1 (G), R6.1
unnamed: Q7.1 (G), R7.2
unnamed: Q8.1 (G), R8.1
unnamed: Q9.1 (G), R9.2
unnamed: Q10.1 (G), R10.1
unnamed: Q11.1 (G), R11.2
unnamed: Q12.1 (G), R12.1
unnamed: Q13.1 (G), R13.2
unnamed: Q14.1 (G), R14.1
unnamed: Q15.1 (G), R15.2
unnamed: Q16.1 (G), R16.1
unnamed: Q17.1 (G), R17.2
unnamed: Q18.1 (G), R18.1
OUT_A: J8.2, R25.1, R26.1, R27.1
OUT_B: J1.2, R22.1, R23.1, R24.1
OUT_C: J2.2, R19.1, R20.1, R21.1
PA_CUR1: J8.3, Q1.3 (S), Q2.2 (D), Q3.3 (S), Q4.2 (D), Q5.3 (S), Q6.2 (D), R25.2, R26.2, R27.2
PA_IN_H: J8.6, R1.1, R3.1, R5.1
PA_IN_L: J8.4, R2.2, R4.2, R6.2
PA_OUT: J8.5
PB_CUR1: J1.3, Q7.3 (S), Q8.2 (D), Q9.3 (S), Q10.2 (D), Q11.3 (S), Q12.2 (D), R22.2, R23.2, R24.2
PB_IN_H: J1.6, R7.1, R9.1, R11.1
PB_IN_L: J1.4, R8.2, R10.2, R12.2
PB_OUT: J1.5
PC_CUR1: J2.3, Q13.3 (S), Q14.2 (D), Q15.3 (S), Q16.2 (D), Q17.3 (S), Q18.2 (D), R19.2, R20.2, R21.2
PC_IN_H: J2.6, R13.1, R15.1, R17.1
PC_IN_L: J2.4, R14.2, R16.2, R18.2
PC_OUT: J2.5
VBAT: C1.1, C3.1, C5.1, C7.1, C9.1, C11.1, C13.1, C15.1, C17.1, Q1.2 (D), Q3.2 (D), Q5.2 (D), Q7.2 (D), Q9.2 (D), Q11.2 (D), Q13.2 (D), Q15.2 (D), Q17.2 (D)

Board: 2 copper layers, 66 parts (0 on the bottom side), 41 nets, no tracks yet.
